brunnerse/Realtime-AES-accelerator/Diagrams/PipelinedAEA.pdf

PipelinedAEA

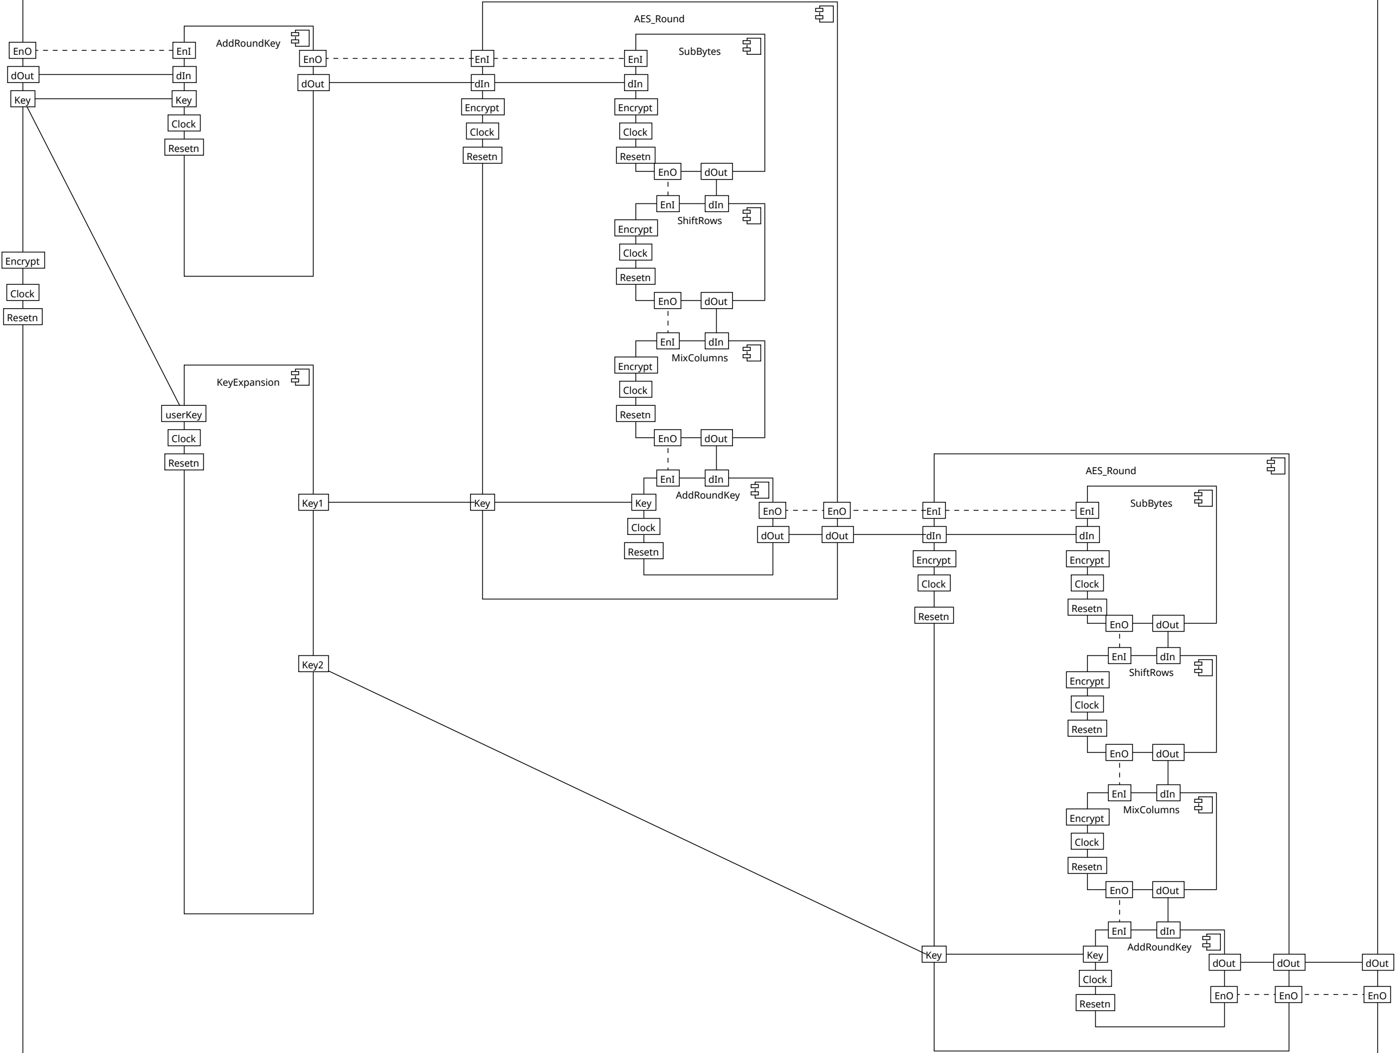
[picture p1: figure]
SubBytes; ShiftRows; AES_Round; MixColumns; AddRoundKey; KeyExpansion; EnI; Key; Clock; Resetn; EnO; dOut; dIn; userKey; Key1; Key2; Encrypt
