brunnerse/Realtime-AES-accelerator/Diagrams/ControlLogic Ports.png

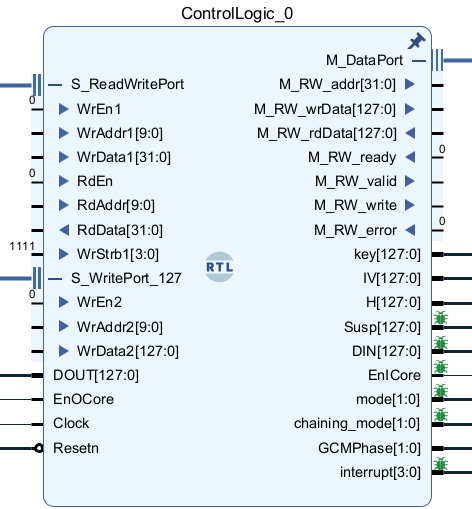
Diagrams/ControlLogic Ports.png
