brunnerse/Realtime-AES-accelerator/Diagrams/simple_ChannelChange_Sim.png

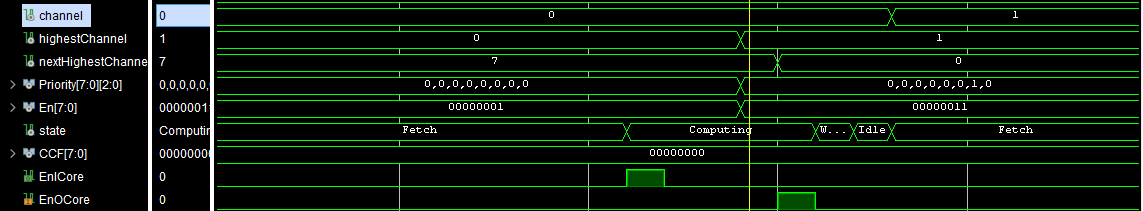
Diagrams/simple_ChannelChange_Sim.png
