brunnerse/Realtime-AES-accelerator/Diagrams/Waveform_GCM_Header_Processing.png

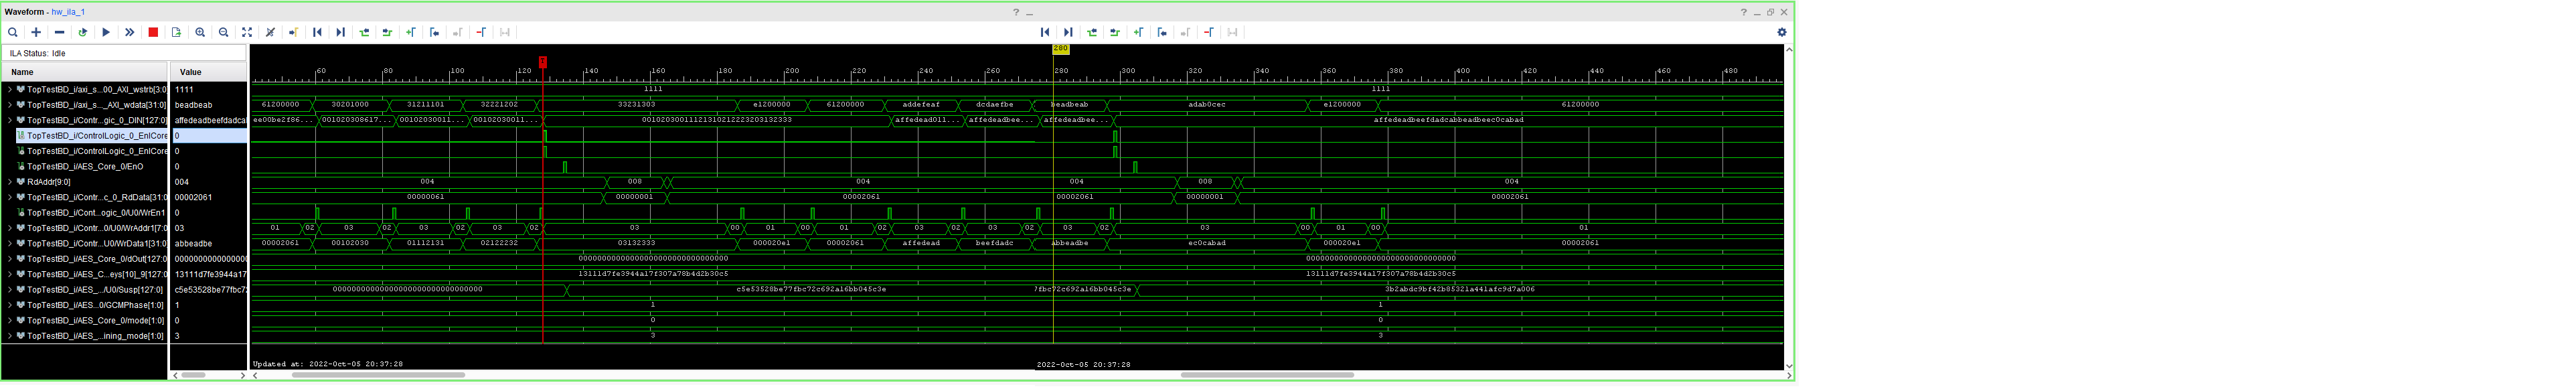
Diagrams/Waveform_GCM_Header_Processing.png
