brunnerse/Realtime-AES-accelerator/Test/aes_test_output.txt

Running AES_Unit_2 test file ../src/aes_test.c
Enabling exceptions..
******************************
* User Peripheral Self Test
******************************

User logic memory test...
   - local memory address is 0x40000000
   - write pattern to local BRAM and read back
   - write/read memory passed

====== Testing Interrupt enable/disable =====
Starting Encryption with Interrupt enabled...
[INTERRUPT] Received Irq 1
[Interrupt] Calling CbFunction at 11C084
=> Interrupt called for channel 0!
Starting KeyExpansion with Interrupt disabled...
Starting KeyExpansion with Interrupt enabled...
[INTERRUPT] Received Irq 1
[Interrupt] Calling CbFunction at 11C084
=> Interrupt called for channel 1337!

====== Testing simple ECB encryption for each channel =====
Plaintext:
        00 10 20 30 01 11 21 31 02 12 22 32 03 13 23 33 

Channel 0:
[INTERRUPT] Received Irq 1
[Interrupt] Calling CbFunction at 11C084
=> Interrupt called for channel 0!
        37 C2 53 91 28 69 90 09 61 7D 4D 89 35 E6 6C 12 

        Encrypt with different key:
        [INTERRUPT] Received Irq 1
        37 C2 53 91 28 69 90 09 61 7D 4D 89 35 E6 6C 12 

        Decrypt with same key:
[INTERRUPT] Received Irq 1
[Interrupt] Calling CbFunction at 11C084
=> Interrupt called for channel 0!
        00 10 20 30 01 11 21 31 02 12 22 32 03 13 23 33 

[TEST] Channel 0 successful:  Yes
Channel 1:
[INTERRUPT] Received Irq 2
[Interrupt] Calling CbFunction at 11C088
=> Interrupt called for channel 1!
        7F CE C6 AA CF C7 E0 9B AD E3 AA 3E B9 A2 42 40 

        Encrypt with different key:
        [INTERRUPT] Received Irq 2
        37 C2 53 91 28 69 90 09 61 7D 4D 89 35 E6 6C 12 

        Decrypt with same key:
[INTERRUPT] Received Irq 2
[Interrupt] Calling CbFunction at 11C088
=> Interrupt called for channel 1!
        00 10 20 30 01 11 21 31 02 12 22 32 03 13 23 33 

[TEST] Channel 1 successful:  Yes
Channel 2:
[INTERRUPT] Received Irq 4
[Interrupt] Calling CbFunction at 11C08C
=> Interrupt called for channel 2!
        94 A5 46 5F FE AE AF 81 DE A1 1C 34 F4 08 63 A1 

        Encrypt with different key:
        [INTERRUPT] Received Irq 4
        37 C2 53 91 28 69 90 09 61 7D 4D 89 35 E6 6C 12 

        Decrypt with same key:
[INTERRUPT] Received Irq 4
[Interrupt] Calling CbFunction at 11C08C
=> Interrupt called for channel 2!
        00 10 20 30 01 11 21 31 02 12 22 32 03 13 23 33 

[TEST] Channel 2 successful:  Yes
Channel 3:
[INTERRUPT] Received Irq 8
[Interrupt] Calling CbFunction at 11C090
=> Interrupt called for channel 3!
        85 51 01 76 4E F4 7C E9 09 62 D0 1B 0F B6 42 4C 

        Encrypt with different key:
        [INTERRUPT] Received Irq 8
        37 C2 53 91 28 69 90 09 61 7D 4D 89 35 E6 6C 12 

        Decrypt with same key:
[INTERRUPT] Received Irq 8
[Interrupt] Calling CbFunction at 11C090
=> Interrupt called for channel 3!
        00 10 20 30 01 11 21 31 02 12 22 32 03 13 23 33 

[TEST] Channel 3 successful:  Yes
Channel 4:
[INTERRUPT] Received Irq 10
[Interrupt] Calling CbFunction at 11C094
=> Interrupt called for channel 4!
        D8 43 A0 CD B1 4C 40 0A 67 91 DC F6 50 42 0A F1 

        Encrypt with different key:
        [INTERRUPT] Received Irq 10
        37 C2 53 91 28 69 90 09 61 7D 4D 89 35 E6 6C 12 

        Decrypt with same key:
[INTERRUPT] Received Irq 10
[Interrupt] Calling CbFunction at 11C094
=> Interrupt called for channel 4!
        00 10 20 30 01 11 21 31 02 12 22 32 03 13 23 33 

[TEST] Channel 4 successful:  Yes
Channel 5:
[INTERRUPT] Received Irq 20
[Interrupt] Calling CbFunction at 11C098
=> Interrupt called for channel 5!
        8E 92 87 E4 6E 09 D7 13 61 60 DE 90 4D 09 BA 57 

        Encrypt with different key:
        [INTERRUPT] Received Irq 20
        37 C2 53 91 28 69 90 09 61 7D 4D 89 35 E6 6C 12 

        Decrypt with same key:
[INTERRUPT] Received Irq 20
[Interrupt] Calling CbFunction at 11C098
=> Interrupt called for channel 5!
        00 10 20 30 01 11 21 31 02 12 22 32 03 13 23 33 

[TEST] Channel 5 successful:  Yes
Channel 6:
[INTERRUPT] Received Irq 40
[Interrupt] Calling CbFunction at 11C09C
=> Interrupt called for channel 6!
        BE 49 74 2A 9D 77 DF D6 B8 33 33 2F F9 68 56 03 

        Encrypt with different key:
        [INTERRUPT] Received Irq 40
        37 C2 53 91 28 69 90 09 61 7D 4D 89 35 E6 6C 12 

        Decrypt with same key:
[INTERRUPT] Received Irq 40
[Interrupt] Calling CbFunction at 11C09C
=> Interrupt called for channel 6!
        00 10 20 30 01 11 21 31 02 12 22 32 03 13 23 33 

[TEST] Channel 6 successful:  Yes
Channel 7:
[INTERRUPT] Received Irq 80
[Interrupt] Calling CbFunction at 11C0A0
=> Interrupt called for channel 7!
        20 FE 98 3B 01 36 CB 64 B1 9F 61 CD 57 D9 80 86 

        Encrypt with different key:
        [INTERRUPT] Received Irq 80
        37 C2 53 91 28 69 90 09 61 7D 4D 89 35 E6 6C 12 

        Decrypt with same key:
[INTERRUPT] Received Irq 80
[Interrupt] Calling CbFunction at 11C0A0
=> Interrupt called for channel 7!
        00 10 20 30 01 11 21 31 02 12 22 32 03 13 23 33 

[TEST] Channel 7 successful:  Yes

====== Testing different data sizes =====
Starting encryption...
[INTERRUPT] Received Irq 8
        00 10 20 30 01 11 21 31 02 12 22 32 03 13 23 33 
        01 10 20 30 01 11 21 31 02 12 22 32 03 13 23 33 

        AE DF 39 43 11 2F 08 82 78 12 C7 68 77 92 FF 64 
        2F A5 E5 A2 40 EF 34 00 DE 5A DB F3 DD FD AD 36 

Starting decryption...
[INTERRUPT] Received Irq 8
        00 10 20 30 01 11 21 31 02 12 22 32 03 13 23 33 
        01 10 20 30 01 11 21 31 02 12 22 32 03 13 23 33 

[TEST] Size 128 (addresses 0x1000000 -> 0x1000080) successful:  Yes
Starting encryption...
[INTERRUPT] Received Irq 8
        08 10 20 30 01 11 21 31 02 12 22 32 03 13 23 33 
        09 10 20 30 01 11 21 31 02 12 22 32 03 13 23 33 

        F1 A1 E4 08 A1 85 8A 8F 97 3D 11 7C 71 49 2F 9B 
        C7 8F 20 8B 3C 64 F6 A3 B2 BA EC CB 87 14 20 39 

Starting decryption...
[INTERRUPT] Received Irq 8
        08 10 20 30 01 11 21 31 02 12 22 32 03 13 23 33 
        09 10 20 30 01 11 21 31 02 12 22 32 03 13 23 33 

[TEST] Size 256 (addresses 0x1000000 -> 0x1000100) successful:  Yes
Starting encryption...
[INTERRUPT] Received Irq 8
        18 10 20 30 01 11 21 31 02 12 22 32 03 13 23 33 
        19 10 20 30 01 11 21 31 02 12 22 32 03 13 23 33 

        FF E0 86 BB DA F6 8A 13 77 79 EF 12 FB 8C 80 1C 
        82 1F CF 64 69 AB 59 F7 12 FF 57 F4 7C 77 0C 21 

Starting decryption...
[INTERRUPT] Received Irq 8
        18 10 20 30 01 11 21 31 02 12 22 32 03 13 23 33 
        19 10 20 30 01 11 21 31 02 12 22 32 03 13 23 33 

[TEST] Size 512 (addresses 0x1000000 -> 0x1000200) successful:  Yes
Starting encryption...
[INTERRUPT] Received Irq 8
        38 10 20 30 01 11 21 31 02 12 22 32 03 13 23 33 
        39 10 20 30 01 11 21 31 02 12 22 32 03 13 23 33 

        AF 28 16 45 35 66 BE 9B 49 84 63 73 F8 95 38 5B 
        BE 1E 1E C0 24 BD 6D 24 E9 98 2C CE 98 6F F2 BB 

Starting decryption...
[INTERRUPT] Received Irq 8
        38 10 20 30 01 11 21 31 02 12 22 32 03 13 23 33 
        39 10 20 30 01 11 21 31 02 12 22 32 03 13 23 33 

[TEST] Size 1024 (addresses 0x1000000 -> 0x1000400) successful:  Yes
Starting encryption...
[INTERRUPT] Received Irq 8
        78 10 20 30 01 11 21 31 02 12 22 32 03 13 23 33 
        79 10 20 30 01 11 21 31 02 12 22 32 03 13 23 33 

        6E D2 C9 38 0C A5 67 EB EF B5 B0 45 A1 CD EF A0 
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
[INTERRUPT] Received Irq 2
Ciphertext:
        F1 20 80 EA 46 8D C9 F0 B6 01 91 8A 30 69 3D ED 
        EB 7E 93 77 21 D5 26 1A 72 4F 50 40 99 64 70 14 
        4D 54 F4 B8 08 54 30 A7 C1 6F 17 74 60 67 E9 10 

Tag after encryption:
        A7 45 9D AE C1 C2 AC A4 26 7C 50 D3 68 57 45 62 

[INTERRUPT] Received Irq 2
[INTERRUPT] Received Irq 2
[INTERRUPT] Received Irq 2
[INTERRUPT] Received Irq 2
Deciphered Ciphertext:
        01 10 20 30 01 11 21 31 02 12 22 32 03 13 23 33 
        00 10 20 30 01 11 21 31 02 12 22 32 03 13 23 33 
        00 01 02 03 04 05 06 07 08 09 0A 0B 0C 0D 0E 0F 

Tag after decryption:
        A7 45 9D AE C1 C2 AC A4 26 7C 50 D3 68 57 45 62 

[TEST] Passed: Tags are equal
Processed all AES tests.
