brunnerse/Realtime-AES-accelerator/Vivado/AES_Unit_Stage2_comparison_CDMA.pdf

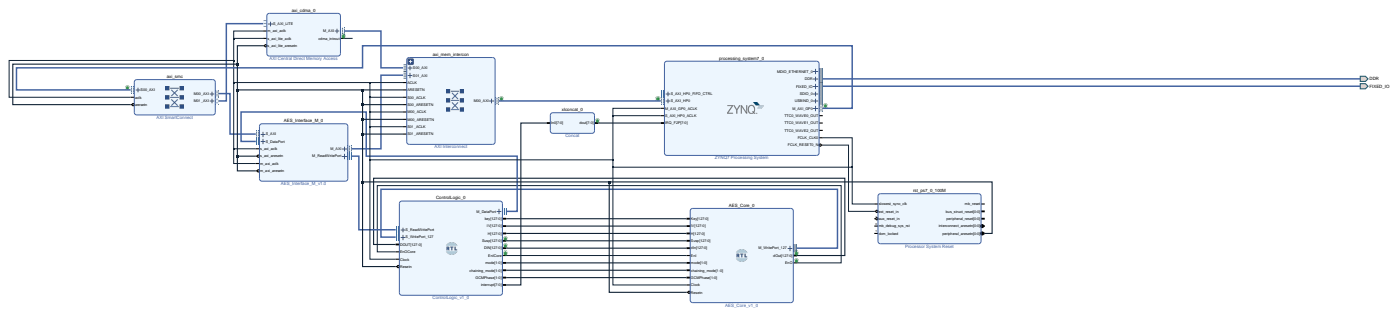
[picture p5: page 1]
AES_Core_0; AES_Core_v1_0; M_WritePort_127; Key[127:0]; IV[127:0] H[127:0] Susp[127:0] dIn[127:0] EnI; dOut[127:0] mode[1:0]; EnO; AES_Interface_M_0; AES_Interface_M_v1.0; S_AXI; M_AXI M_ReadWritePort; S_DataPort s_axi_aclk; s_axi_aresetn m_axi_aclk m_axi_aresetn; ControlLogic_0; ControlLogic_v1_0; S_ReadWritePort; M_DataPort; S_WritePort_127; key[127:0]; IV[127:0] H[127:0] Susp[127:0] DIN[127:0] DOUT[127:0]; EnICore EnOCore; mode[1:0] chaining_mode[1:0] GCMPhase[1:0]; interrupt[7:0]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

AXI Central Direct Memory Access

Processor System Reset

chaining_mode[1:0] GCMPhase[1:0] Clock Resetn
