brunnerse/Realtime-AES-accelerator/Diagrams/AES_Unit.pdf

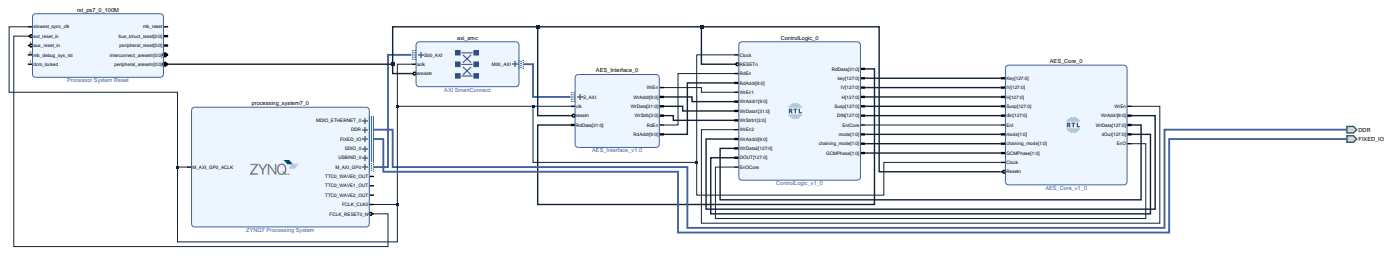
[picture p6: page 1]
rst_ps7_0_100M; slowest_sync_clk ext_reset_in; aux_reset_in ¹; mb_debug_sys_rst ⁰; dcm_locked ¹; mb_reset bus_struct_reset[0:0] peripheral_reset[0:0]; interconnect_aresetn[0:0] peripheral_aresetn[0:0]; processing_system7_0; ZYNQ7 Processing System; MDIO_ETHERNET_0 DDR; FIXED_IO; SDIO_0 USBIND_0 M_AXI_GP0 TTC0_WAVE0_OUT; TTC0_WAVE1_OUT; TTC0_WAVE2_OUT; M_AXI_GP0_ACLK; FCLK_CLK0 FCLK_RESET0_N; axi_smc; AXI SmartConnect; S00_AXI aclk; M00_AXI aresetn; AES_Interface_0; AES_Interface_v1.0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

Clock RESETn RdEn RdAddr[9:0]

Processor System Reset

RdData[31:0]
key[127:0]
IV[127:0] H[127:0] Susp[127:0] DIN[127:0]

WrEn WrAddr[9:0] WrData[31:0] WrStrb[3:0] RdEn RdAddr[9:0]

dIn[127:0]
EnI
EnO mode[1:0] chaining_mode[1:0] GCMPhase[1:0] Clock Resetn
