brunnerse/Realtime-AES-accelerator/AES/AES.srcs/sources_1/new/ControlLogic.vhd

----------------------------------------------------------------------------------
-- Company: 
-- Engineer: 
-- 
-- Create Date: 28.07.2022 21:02:50
-- Design Name: 
-- Module Name: ControlLogic - Behavioral
-- Project Name: 
-- Target Devices: 
-- Tool Versions: 
-- Description: 
-- 
-- Dependencies: 
-- 
-- Revision:
-- Revision 0.01 - File Created
-- Additional Comments:
-- 
----------------------------------------------------------------------------------


library IEEE;
use IEEE.STD_LOGIC_1164.ALL;
use work.common.ALL;

-- Uncomment the following library declaration if using
-- arithmetic functions with Signed or Unsigned values
--use IEEE.NUMERIC_STD.ALL;

-- Uncomment the following library declaration if instantiating
-- any Xilinx leaf cells in this code.
--library UNISIM;
--use UNISIM.VComponents.all;




entity ControlLogic is
  Port ( 
-- global signals
    RESETn   : in std_logic;
-- Ports to the AHB interface
    AES_KEYRx   : in std_logic_vector (KEY_SIZE-1 downto 0);
    AES_IVRx    : in std_logic_vector (KEY_SIZE-1 downto 0);
    AES_SR  : out std_logic_vector (31 downto 0);
    AES_CR : in std_logic_vector (31 downto 0);
    AES_DINR : in std_logic_vector (31 downto 0);
    AES_DOUTR : out std_logic_vector (31 downto 0);
-- Ports to the AES Core
    key : out std_logic_vector (KEY_SIZE-1 downto 0);
    IV : out std_logic_vector (KEY_SIZE-1 downto 0);
    DIN : out std_logic_vector (KEY_SIZE-1 downto 0); -- TODO 32 oder 128 bit?
    DOUT : in std_logic_vector (KEY_SIZE-1 downto 0);
-- Control to AES core
    en : out std_logic;
    mode : out std_logic_vector (1 downto 0);
    chaining_mode : out std_logic_vector (2 downto 0)
  );
end ControlLogic;

architecture Behavioral of ControlLogic is


-- TODO Was mit SUSPRx anfangen?
signal AES_SUSPRx  : std_logic_vector (31 downto 0);

begin

status <= AES_SR;
AES_CR <= control;

DIN <= AES_DINR;
AES_DOUTR <= DOUT;

key <= AES_KEYRx;
IV <= AES_IVRx;

-- set AES control signals
en <= AES_CR(0);
mode <= AES_CR(4 downto 3);
chaining_mode <= AES_CR(16) & AES_CR(6 downto 5);


-- TODO Process to clear AES_SR
process (RESETn)
begin
if RESETn = '0' then
    AES_SR <= x"00000000";
end if;
end process;


end Behavioral;
