brunnerse/Realtime-AES-accelerator/VHDL/AES_Unit.vhd

library IEEE;
use IEEE.STD_LOGIC_1164.ALL;
use work.common.ALL;
use work.addresses.ALL;

-- Uncomment the following library declaration if using
-- arithmetic functions with Signed or Unsigned values
use IEEE.NUMERIC_STD.ALL;


entity AES_Unit is
  Generic (
    LITTLE_ENDIAN : boolean := true; -- whether the AXI bus data signals use little endian byte order
    REG_KEY_WRITEONLY : boolean := true; -- whether the registers Key, IV, Susp and H are not allowed to be read for security 
    NO_REG_WRITE_WHEN_ENABLED : boolean := true; -- whether writing to a channel is only possible when the channel is not enabled 
    NUM_CHANNELS : integer range 1 to 256 := 8; -- the number of channels; the upper bound is equal to MAX_CHANNELS defined in common.vhd 
    -- Parameters of the AXI Slave Bus Interface S_AXI
    C_S_AXI_ID_WIDTH	: integer	:= 1;
    C_S_AXI_DATA_WIDTH	: integer	:= 32;
    C_S_AXI_ADDR_WIDTH	: integer	:= ADDR_WIDTH;
    C_S_AXI_AWUSER_WIDTH	: integer	:= 1;
    C_S_AXI_ARUSER_WIDTH	: integer	:= 1;
    C_S_AXI_WUSER_WIDTH	: integer	:= 1;
    C_S_AXI_RUSER_WIDTH	: integer	:= 1;
    C_S_AXI_BUSER_WIDTH	: integer	:= 1;
    -- Parameters of AXI Master Bus Interface M_AXI
    C_M_AXI_ID_WIDTH	: integer	:= 1;
    C_M_AXI_ADDR_WIDTH	: integer	:= 32;
    C_M_AXI_DATA_WIDTH	: integer	:= 32;
    C_M_AXI_AWUSER_WIDTH	: integer	:= 1;
    C_M_AXI_ARUSER_WIDTH	: integer	:= 1;
    C_M_AXI_WUSER_WIDTH	: integer	:= 1;
    C_M_AXI_RUSER_WIDTH	: integer	:= 1;
    C_M_AXI_BUSER_WIDTH	: integer	:= 1
  );
  Port ( 
	-- Ports of Axi Slave Bus Interface S_AXI
		s_axi_aclk	: in std_logic;
		s_axi_aresetn	: in std_logic;
		s_axi_awid	: in std_logic_vector(C_S_AXI_ID_WIDTH-1 downto 0);
		s_axi_awaddr	: in std_logic_vector(C_S_AXI_ADDR_WIDTH-1 downto 0);
		s_axi_awlen	: in std_logic_vector(7 downto 0);
		s_axi_awsize	: in std_logic_vector(2 downto 0);
		s_axi_awburst	: in std_logic_vector(1 downto 0);
		s_axi_awlock	: in std_logic;
		s_axi_awcache	: in std_logic_vector(3 downto 0);
		s_axi_awprot	: in std_logic_vector(2 downto 0);
		s_axi_awqos	: in std_logic_vector(3 downto 0);
		s_axi_awregion	: in std_logic_vector(3 downto 0);
		s_axi_awuser	: in std_logic_vector(C_S_AXI_AWUSER_WIDTH-1 downto 0);
		s_axi_awvalid	: in std_logic;
		s_axi_awready	: out std_logic;
		s_axi_wdata	: in std_logic_vector(C_S_AXI_DATA_WIDTH-1 downto 0);
		s_axi_wstrb	: in std_logic_vector((C_S_AXI_DATA_WIDTH/8)-1 downto 0);
		s_axi_wlast	: in std_logic;
		s_axi_wuser	: in std_logic_vector(C_S_AXI_WUSER_WIDTH-1 downto 0);
		s_axi_wvalid	: in std_logic;
		s_axi_wready	: out std_logic;
		s_axi_bid	: out std_logic_vector(C_S_AXI_ID_WIDTH-1 downto 0);
		s_axi_bresp	: out std_logic_vector(1 downto 0);
		s_axi_buser	: out std_logic_vector(C_S_AXI_BUSER_WIDTH-1 downto 0);
		s_axi_bvalid	: out std_logic;
		s_axi_bready	: in std_logic;
		s_axi_arid	: in std_logic_vector(C_S_AXI_ID_WIDTH-1 downto 0);
		s_axi_araddr	: in std_logic_vector(C_S_AXI_ADDR_WIDTH-1 downto 0);
		s_axi_arlen	: in std_logic_vector(7 downto 0);
		s_axi_arsize	: in std_logic_vector(2 downto 0);
		s_axi_arburst	: in std_logic_vector(1 downto 0);
		s_axi_arlock	: in std_logic;
		s_axi_arcache	: in std_logic_vector(3 downto 0);
		s_axi_arprot	: in std_logic_vector(2 downto 0);
		s_axi_arqos	: in std_logic_vector(3 downto 0);
		s_axi_arregion	: in std_logic_vector(3 downto 0);
		s_axi_aruser	: in std_logic_vector(C_S_AXI_ARUSER_WIDTH-1 downto 0);
		s_axi_arvalid	: in std_logic;
		s_axi_arready	: out std_logic;
		s_axi_rid	: out std_logic_vector(C_S_AXI_ID_WIDTH-1 downto 0);
		s_axi_rdata	: out std_logic_vector(C_S_AXI_DATA_WIDTH-1 downto 0);
		s_axi_rresp	: out std_logic_vector(1 downto 0);
		s_axi_rlast	: out std_logic;
		s_axi_ruser	: out std_logic_vector(C_S_AXI_RUSER_WIDTH-1 downto 0);
		s_axi_rvalid	: out std_logic;
		s_axi_rready	: in std_logic;

		-- Ports of Axi Master Bus Interface M_AXI
		m_axi_aclk	: in std_logic;
		m_axi_aresetn	: in std_logic;
		m_axi_awid	: out std_logic_vector(C_M_AXI_ID_WIDTH-1 downto 0);
		m_axi_awaddr	: out std_logic_vector(C_M_AXI_ADDR_WIDTH-1 downto 0);
		m_axi_awlen	: out std_logic_vector(7 downto 0);
		m_axi_awsize	: out std_logic_vector(2 downto 0);
		m_axi_awburst	: out std_logic_vector(1 downto 0);
		m_axi_awlock	: out std_logic;
		m_axi_awcache	: out std_logic_vector(3 downto 0);
		m_axi_awprot	: out std_logic_vector(2 downto 0);
		m_axi_awqos	: out std_logic_vector(3 downto 0);
		m_axi_awuser	: out std_logic_vector(C_M_AXI_AWUSER_WIDTH-1 downto 0);
		m_axi_awvalid	: out std_logic;
		m_axi_awready	: in std_logic;
		m_axi_wdata	: out std_logic_vector(C_M_AXI_DATA_WIDTH-1 downto 0);
		m_axi_wstrb	: out std_logic_vector(C_M_AXI_DATA_WIDTH/8-1 downto 0);
		m_axi_wlast	: out std_logic;
		m_axi_wuser	: out std_logic_vector(C_M_AXI_WUSER_WIDTH-1 downto 0);
		m_axi_wvalid	: out std_logic;
		m_axi_wready	: in std_logic;
		m_axi_bid	: in std_logic_vector(C_M_AXI_ID_WIDTH-1 downto 0);
		m_axi_bresp	: in std_logic_vector(1 downto 0);
		m_axi_buser	: in std_logic_vector(C_M_AXI_BUSER_WIDTH-1 downto 0);
		m_axi_bvalid	: in std_logic;
		m_axi_bready	: out std_logic;
		m_axi_arid	: out std_logic_vector(C_M_AXI_ID_WIDTH-1 downto 0);
		m_axi_araddr	: out std_logic_vector(C_M_AXI_ADDR_WIDTH-1 downto 0);
		m_axi_arlen	: out std_logic_vector(7 downto 0);
		m_axi_arsize	: out std_logic_vector(2 downto 0);
		m_axi_arburst	: out std_logic_vector(1 downto 0);
		m_axi_arlock	: out std_logic;
		m_axi_arcache	: out std_logic_vector(3 downto 0);
		m_axi_arprot	: out std_logic_vector(2 downto 0);
		m_axi_arqos	: out std_logic_vector(3 downto 0);
		m_axi_aruser	: out std_logic_vector(C_M_AXI_ARUSER_WIDTH-1 downto 0);
		m_axi_arvalid	: out std_logic;
		m_axi_arready	: in std_logic;
		m_axi_rid	: in std_logic_vector(C_M_AXI_ID_WIDTH-1 downto 0);
		m_axi_rdata	: in std_logic_vector(C_M_AXI_DATA_WIDTH-1 downto 0);
		m_axi_rresp	: in std_logic_vector(1 downto 0);
		m_axi_rlast	: in std_logic;
		m_axi_ruser	: in std_logic_vector(C_M_AXI_RUSER_WIDTH-1 downto 0);
		m_axi_rvalid	: in std_logic;
		m_axi_rready	: out std_logic;
		-- Interrupt out
		aes_introut : out std_logic
  );
end entity;

architecture Structural of AES_Unit is

-- Define ahb ports as xiling AHB_INTERFACE
ATTRIBUTE X_INTERFACE_INFO : STRING;
ATTRIBUTE X_INTERFACE_PARAMETER : STRING;


-- signals to master AES Interface
signal    M_RV_valid :  std_logic;
signal    M_RV_ready : std_logic;
signal    M_RV_addr : std_logic_vector(31 downto 0);
signal    M_RV_wrData : block_t;
signal    M_RV_rdData : block_t;
signal    M_RV_write : std_logic; 
signal    M_RV_error : std_logic;

signal IWrAddr, IRdAddr : std_logic_vector(C_S_AXI_ADDR_WIDTH-1 downto 0);
signal WrAddrCore : std_logic_vector(ADDR_REGISTER_BITS-1 downto 0);
signal IWrData, IRdData : std_logic_vector(31 downto 0);
signal WrDataCore : block_t;
signal IWrEn, IRdEn, WrEnCore : std_logic;
signal IWrStrb : std_logic_vector(3 downto 0);

-- signals between ControlLogic and Core
signal key : key_t;
signal IV, DIN, DOUT, H, Susp : block_t;
signal EnICore, EnOCore : std_logic;

signal mode, GCMPhase, chaining_mode : mode_t;


begin


i_AES_Interface : entity work.AES_Interface
    generic map (
		LITTLE_ENDIAN 		=> LITTLE_ENDIAN,
        C_S_AXI_ID_WIDTH	=> C_S_AXI_ID_WIDTH,	
        C_S_AXI_DATA_WIDTH	=> C_S_AXI_DATA_WIDTH,	
        C_S_AXI_ADDR_WIDTH	=> C_S_AXI_ADDR_WIDTH,	
        C_S_AXI_AWUSER_WIDTH => C_S_AXI_AWUSER_WIDTH,	
        C_S_AXI_ARUSER_WIDTH => C_S_AXI_ARUSER_WIDTH,	
        C_S_AXI_WUSER_WIDTH	=> C_S_AXI_WUSER_WIDTH,	
        C_S_AXI_RUSER_WIDTH	=> C_S_AXI_RUSER_WIDTH,	
        C_S_AXI_BUSER_WIDTH	=> C_S_AXI_BUSER_WIDTH,	
        
        C_M_AXI_ID_WIDTH	=> C_M_AXI_ID_WIDTH,	
        C_M_AXI_ADDR_WIDTH	=> C_M_AXI_ADDR_WIDTH,	
        C_M_AXI_DATA_WIDTH	=> C_M_AXI_DATA_WIDTH,	
        C_M_AXI_AWUSER_WIDTH => C_M_AXI_AWUSER_WIDTH,	
        C_M_AXI_ARUSER_WIDTH => C_M_AXI_ARUSER_WIDTH,	
        C_M_AXI_WUSER_WIDTH	=> C_M_AXI_WUSER_WIDTH,	
        C_M_AXI_RUSER_WIDTH	=> C_M_AXI_RUSER_WIDTH,	
        C_M_AXI_BUSER_WIDTH	=> C_M_AXI_BUSER_WIDTH	)
    port map (
        RdEn => IRdEn,
        RdAddr => IRdAddr,
        RdData => IRdData, 
        WrEn => IWrEn,
        WrAddr => IWrAddr, 
        WrData => IWrData,
        WrStrb => IWrStrb,
        S_RV_valid => M_RV_valid,
        S_RV_ready => M_RV_ready,
        S_RV_addr => M_RV_addr,
        S_RV_wrData => M_RV_wrData,
        S_RV_rdData => M_RV_rdData,
        S_RV_write => M_RV_write,
        S_RV_error => M_RV_error,
        -- Slave AXI port
        s_axi_aclk => s_axi_aclk,
		s_axi_aresetn => s_axi_aresetn,
		s_axi_awid => s_axi_awid,
		s_axi_awaddr => s_axi_awaddr,
		s_axi_awlen => s_axi_awlen,
		s_axi_awsize => s_axi_awsize,
		s_axi_awburst => s_axi_awburst,
		s_axi_awlock => s_axi_awlock,
		s_axi_awcache => s_axi_awcache,
		s_axi_awprot => s_axi_awprot,
		s_axi_awqos => s_axi_awqos,
		s_axi_awregion => s_axi_awregion,
		s_axi_awuser => s_axi_awuser,
		s_axi_awvalid => s_axi_awvalid,
		s_axi_awready => s_axi_awready,
		s_axi_wdata => s_axi_wdata,
		s_axi_wstrb => s_axi_wstrb,
		s_axi_wlast => s_axi_wlast,
		s_axi_wuser => s_axi_wuser,
		s_axi_wvalid => s_axi_wvalid,
		s_axi_wready => s_axi_wready,
		s_axi_bid => s_axi_bid,
		s_axi_bresp => s_axi_bresp,
		s_axi_buser => s_axi_buser,
		s_axi_bvalid => s_axi_bvalid,
		s_axi_bready => s_axi_bready,
		s_axi_arid => s_axi_arid,
		s_axi_araddr => s_axi_araddr,
		s_axi_arlen => s_axi_arlen,
		s_axi_arsize => s_axi_arsize,
		s_axi_arburst => s_axi_arburst,
		s_axi_arlock => s_axi_arlock,
		s_axi_arcache => s_axi_arcache,
		s_axi_arprot => s_axi_arprot,
		s_axi_arqos => s_axi_arqos,
		s_axi_arregion => s_axi_arregion,
		s_axi_aruser => s_axi_aruser,
		s_axi_arvalid => s_axi_arvalid,
		s_axi_arready => s_axi_arready,
		s_axi_rid => s_axi_rid,
		s_axi_rdata => s_axi_rdata,
		s_axi_rresp => s_axi_rresp,
		s_axi_rlast => s_axi_rlast,
		s_axi_ruser => s_axi_ruser,
		s_axi_rvalid => s_axi_rvalid,
		s_axi_rready => s_axi_rready,
		-- Ports of Axi Master Bus Interface M_AXI
		m_axi_aclk => m_axi_aclk,
		m_axi_aresetn => m_axi_aresetn,
		m_axi_awid => m_axi_awid,
		m_axi_awaddr => m_axi_awaddr,
		m_axi_awlen => m_axi_awlen,
		m_axi_awsize => m_axi_awsize,
		m_axi_awburst => m_axi_awburst,
		m_axi_awlock => m_axi_awlock,
		m_axi_awcache => m_axi_awcache,
		m_axi_awprot => m_axi_awprot,
		m_axi_awqos => m_axi_awqos,
		m_axi_awuser => m_axi_awuser,
		m_axi_awvalid => m_axi_awvalid,
		m_axi_awready => m_axi_awready,
		m_axi_wdata => m_axi_wdata,
		m_axi_wstrb => m_axi_wstrb,
		m_axi_wlast => m_axi_wlast,
		m_axi_wuser => m_axi_wuser,
		m_axi_wvalid => m_axi_wvalid,
		m_axi_wready => m_axi_wready,
		m_axi_bid => m_axi_bid,
		m_axi_bresp => m_axi_bresp,
		m_axi_buser => m_axi_buser,
		m_axi_bvalid => m_axi_bvalid,
		m_axi_bready => m_axi_bready,
		m_axi_arid => m_axi_arid,
		m_axi_araddr => m_axi_araddr,
		m_axi_arlen => m_axi_arlen,
		m_axi_arsize => m_axi_arsize,
		m_axi_arburst => m_axi_arburst,
		m_axi_arlock => m_axi_arlock,
		m_axi_arcache => m_axi_arcache,
		m_axi_arprot => m_axi_arprot,
		m_axi_arqos => m_axi_arqos,
		m_axi_aruser => m_axi_aruser,
		m_axi_arvalid => m_axi_arvalid,
		m_axi_arready => m_axi_arready,
		m_axi_rid => m_axi_rid,
		m_axi_rdata => m_axi_rdata,
		m_axi_rresp => m_axi_rresp,
		m_axi_rlast => m_axi_rlast,
		m_axi_ruser => m_axi_ruser,
		m_axi_rvalid => m_axi_rvalid,
		m_axi_rready => m_axi_rready
     );


    
i_ControlLogic : entity work.ControlLogic
    generic map(
        LITTLE_ENDIAN => LITTLE_ENDIAN,
    	REG_KEY_WRITEONLY => REG_KEY_WRITEONLY, 
    	NO_REG_WRITE_WHEN_ENABLED => NO_REG_WRITE_WHEN_ENABLED, 
        NUM_CHANNELS => NUM_CHANNELS)
    port map(
        M_RV_valid => M_RV_valid,
        M_RV_ready => M_RV_ready,
        M_RV_error => M_RV_error, 
        M_RV_rdData => M_RV_rdData,
        M_RV_wrData => M_RV_wrData,
        M_RV_addr => M_RV_addr,
        M_RV_write => M_RV_write,
        RdEn => IRdEn,
        RdAddr => IRdAddr,
        RdData => IRdData, 
        WrEn1 => IWrEn,
        WrAddr1 => IWrAddr,
        WrData1 => IWrData,
        WrStrb1 => IWrStrb,
        WrEn2 => WrEnCore,
        WrAddr2 => WrAddrCore,
        WrData2 => WrDataCore, 
        key => key,
        IV => IV,
        H => H,
        Susp => Susp,
        DIN => DIN,
        DOUT => DOUT,
        EnOCore => EnOCore,
        EnICore => EnICore,
        mode => mode,
        chaining_mode => chaining_mode,
        GCMPhase => GCMPhase,
        aes_introut => aes_introut,
        Clock => s_axi_aclk,
        Resetn => s_axi_aresetn
    );

i_Core : entity work.AES_Core
    generic map (
        ADDR_IV => ADDR_IVR,
        ADDR_SUSP => ADDR_SUSPR,
        ADDR_H => ADDR_HR)
    port map (
        key => key,
        IV => IV,
        H => H,
        Susp => Susp,
        WrEn => WrEnCore,
        WrAddr => WrAddrCore,
        WrData => WrDataCore,
        DIN => DIN,
        DOUT => DOUT,
        EnI => EnICore,
        EnO => EnOCore,
        mode => mode,
        chaining_mode => chaining_mode,
        GCMPhase => GCMPhase,
        Clock => s_axi_aclk,
        Resetn => s_axi_aresetn
    );

end architecture;
