brunnerse/Realtime-AES-accelerator/VHDL/AES_Core/AEA/Submodules/sbox.vhd

library IEEE;
use IEEE.STD_LOGIC_1164.ALL;
use IEEE.NUMERIC_STD.ALL;

package aes_sbox is


function SubBytesInVec(vec : std_logic_vector) return std_logic_vector;
function InvSubBytesInVec(vec : std_logic_vector) return std_logic_vector;

type SBOX is array(255 downto 0) of std_logic_vector(7 downto 0);

constant sbox_encrypt : SBOX := (
	  0 => x"63",
	  1 => x"7c",
	  2 => x"77",
	  3 => x"7b",
	  4 => x"f2",
	  5 => x"6b",
	  6 => x"6f",
	  7 => x"c5",
	  8 => x"30",
	  9 => x"01",
	 10 => x"67",
	 11 => x"2b",
	 12 => x"fe",
	 13 => x"d7",
	 14 => x"ab",
	 15 => x"76",
	 16 => x"ca",
	 17 => x"82",
	 18 => x"c9",
	 19 => x"7d",
	 20 => x"fa",
	 21 => x"59",
	 22 => x"47",
	 23 => x"f0",
	 24 => x"ad",
	 25 => x"d4",
	 26 => x"a2",
	 27 => x"af",
	 28 => x"9c",
	 29 => x"a4",
	 30 => x"72",
	 31 => x"c0",
	 32 => x"b7",
	 33 => x"fd",
	 34 => x"93",
	 35 => x"26",
	 36 => x"36",
	 37 => x"3f",
	 38 => x"f7",
	 39 => x"cc",
	 40 => x"34",
	 41 => x"a5",
	 42 => x"e5",
	 43 => x"f1",
	 44 => x"71",
	 45 => x"d8",
	 46 => x"31",
	 47 => x"15",
	 48 => x"04",
	 49 => x"c7",
	 50 => x"23",
	 51 => x"c3",
	 52 => x"18",
	 53 => x"96",
	 54 => x"05",
	 55 => x"9a",
	 56 => x"07",
	 57 => x"12",
	 58 => x"80",
	 59 => x"e2",
	 60 => x"eb",
	 61 => x"27",
	 62 => x"b2",
	 63 => x"75",
	 64 => x"09",
	 65 => x"83",
	 66 => x"2c",
	 67 => x"1a",
	 68 => x"1b",
	 69 => x"6e",
	 70 => x"5a",
	 71 => x"a0",
	 72 => x"52",
	 73 => x"3b",
	 74 => x"d6",
	 75 => x"b3",
	 76 => x"29",
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
	 98 => x"ab",
	 99 => x"00",
	100 => x"8c",
	101 => x"bc",
	102 => x"d3",
	103 => x"0a",
	104 => x"f7",
	105 => x"e4",
	106 => x"58",
	107 => x"05",
	108 => x"b8",
	109 => x"b3",
	110 => x"45",
	111 => x"06",
	112 => x"d0",
	113 => x"2c",
	114 => x"1e",
	115 => x"8f",
	116 => x"ca",
	117 => x"3f",
	118 => x"0f",
	119 => x"02",
	120 => x"c1",
	121 => x"af",
	122 => x"bd",
	123 => x"03",
	124 => x"01",
	125 => x"13",
	126 => x"8a",
	127 => x"6b",
	128 => x"3a",
	129 => x"91",
	130 => x"11",
	131 => x"41",
	132 => x"4f",
	133 => x"67",
	134 => x"dc",
	135 => x"ea",
	136 => x"97",
	137 => x"f2",
	138 => x"cf",
	139 => x"ce",
	140 => x"f0",
	141 => x"b4",
	142 => x"e6",
	143 => x"73",
	144 => x"96",
	145 => x"ac",
	146 => x"74",
	147 => x"22",
	148 => x"e7",
	149 => x"ad",
	150 => x"35",
	151 => x"85",
	152 => x"e2",
	153 => x"f9",
	154 => x"37",
	155 => x"e8",
	156 => x"1c",
	157 => x"75",
	158 => x"df",
	159 => x"6e",
	160 => x"47",
	161 => x"f1",
	162 => x"1a",
	163 => x"71",
	164 => x"1d",
	165 => x"29",
	166 => x"c5",
	167 => x"89",
	168 => x"6f",
	169 => x"b7",
	170 => x"62",
	171 => x"0e",
	172 => x"aa",
	173 => x"18",
	174 => x"be",
	175 => x"1b",
	176 => x"fc",
	177 => x"56",
	178 => x"3e",
	179 => x"4b",
	180 => x"c6",
	181 => x"d2",
	182 => x"79",
	183 => x"20",
	184 => x"9a",
	185 => x"db",
	186 => x"c0",
	187 => x"fe",
	188 => x"78",
	189 => x"cd",
	190 => x"5a",
	191 => x"f4",
	192 => x"1f",
	193 => x"dd",
	194 => x"a8",
	195 => x"33",
	196 => x"88",
	197 => x"07",
	198 => x"c7",
	199 => x"31",
	200 => x"b1",
	201 => x"12",
	202 => x"10",
	203 => x"59",
	204 => x"27",
	205 => x"80",
	206 => x"ec",
	207 => x"5f",
	208 => x"60",
	209 => x"51",
	210 => x"7f",
	211 => x"a9",
	212 => x"19",
	213 => x"b5",
	214 => x"4a",
	215 => x"0d",
	216 => x"2d",
	217 => x"e5",
	218 => x"7a",
	219 => x"9f",
	220 => x"93",
	221 => x"c9",
	222 => x"9c",
	223 => x"ef",
	224 => x"a0",
	225 => x"e0",
	226 => x"3b",
	227 => x"4d",
	228 => x"ae",
	229 => x"2a",
	230 => x"f5",
	231 => x"b0",
	232 => x"c8",
	233 => x"eb",
	234 => x"bb",
	235 => x"3c",
	236 => x"83",
	237 => x"53",
	238 => x"99",
	239 => x"61",
	240 => x"17",
	241 => x"2b",
	242 => x"04",
	243 => x"7e",
	244 => x"ba",
	245 => x"77",
	246 => x"d6",
	247 => x"26",
	248 => x"e1",
	249 => x"69",
	250 => x"14",
	251 => x"63",
	252 => x"55",
	253 => x"21",
	254 => x"0c",
	255 => x"7d"
);


end package;

package body aes_sbox is

	function SubBytesInVec(vec : std_logic_vector) return std_logic_vector is
		variable result : std_logic_vector(vec'range);
	begin
		for i in 0 to vec'length/8-1 loop
			result(i*8+7 downto i*8) := sbox_encrypt(to_integer(unsigned(vec(i*8+7 downto i*8))));
		end loop;
		return result;
	end function;

	function InvSubBytesInVec(vec : std_logic_vector) return std_logic_vector is
		variable result : std_logic_vector(vec'range);
	begin
		for i in 0 to vec'length/8-1 loop
			result(i*8+7 downto i*8) := sbox_decrypt(to_integer(unsigned(vec(i*8+7 downto i*8))));
		end loop;
		return result;
	end function;

end package body;
