brunnerse/Realtime-AES-accelerator/(commit log)

2022-08-04 Print single-digit hex numbers with two digits in BuildSBox.py
2022-08-09 Remove TABLE type and replace it with COLUMNTABLE
    At this point, encryption works correctly
    [AEA.vhd, AEA_Round.vhd, AddRoundKey.vhd, MixColumns.vhd, ShiftRows.vhd, SubBytes.vhd, TableToVector.vhd, TestComponents.vhd]
2022-08-09 Implement decryption in ShiftRows and MixColumns
    The implementations are tested and correct
    [MixColumns.vhd, ShiftRows.vhd]
2022-08-09 Fix typo in BuildSBox
    [BuildSBox.py, sbox_definition.vhd]
2022-08-09 Make decryption work
    Decryption has been tested, implementation at this point is correct
    [AEA.vhd, TestComponents.vhd]
2022-08-17 Rename reset port to resetn to indicate active low
    [AEA.vhd, AEA_Round.vhd, AES_Core.vhd, AddRoundKey.vhd, KeyExpansion.vhd, MixColumns.vhd, PipelinedAEA.vhd, ShiftRows.vhd]
2022-08-21 Extend AES python script with printing decryption aswell
2022-09-11 Shorten AEA.vhd by running KeyExpansion parallel
    [AEA.vhd, TestAEA.vhd]
2022-09-14 Replace PipelinedAEA with AEA in AES_Core.vhd
    [AES_Core.vhd, KeyExpansion.vhd]
2022-09-22 Start implementing driver for the AES_Interface IP
2022-09-22 Work on driver
2022-09-22 Update drivers of AES_Interface
2022-09-23 Implement more functions of the driver
2022-09-24 Fix inferred latch in ControlLogic
    [ControlLogic.vhd, TestControlLogic.vhd]
2022-09-26 Transform asynchronous resets to synchronous resets, remove latches
    [AEA.vhd, AES_Core.vhd, AES_Mode_ECBCBCCTR.vhd, AES_Mode_GCM.vhd, AXI_Mem_Interface.vhd, AddRoundKey.vhd, ControlLogic.vhd, KeyExpansion.vhd]
2022-09-28 Adapt TESTAEA.vhd to the synchronous reset (longer reset interval)
    [TestAEA.vhd]
2022-09-28 Change Length of chaining_mode from 3 to 2
2022-09-28 Change length of chaining_mode in drivers
2022-10-04 Fix non-constant indices in mulGF process of GCM mode
    [AES_Mode_GCM.vhd]
2022-10-04 Consider encryption or decryptoin in processDataGCM driver function
2022-10-05 Adapt some test files to synchronous reset
    [TestAESCore.vhd, TestAESCoreGCM.vhd]
2022-10-05 Fix small errors in processDataGCM() function of driver
2022-10-06 Add interrupt output signal to ControlLogic
2022-10-06 Create new test file for AES with interrupt
2022-10-06 Add Interrupt function to AES_Interface_M driver
2022-10-06 Add demonstrative code for working interrupt to aestest_interrupt.c
2022-10-12 Adapt Addresses in common.vhd to new DMA interface scheme
2022-10-12 Fix multiple drivers for EnICore signal in ControlLogic
    [ControlLogic.vhd]
2022-10-12 Fix false LittleEndian data forwarding in AES_Interface_M
    [AES_Interface_M_v1_0.vhd]
2022-10-12 Add shell script to quickly replace all driver files in the Vitis Project
2022-10-14 Adapt ControlLogic to DMA-style interface
    A process reads, computes and writes back the data
    The given address and datasize are converted from little endian to big
    endian
2022-10-14 Rewrite the drivers for the new AES DMA-style interface
2022-10-15 Fix write and read address in ControlLogic
    [ControlLogic.vhd, TestControlLogic.vhd]
2022-10-16 Adapt drivers to new channel system
2022-10-17 Add functions to get and set the priority of a channel to the drivers
2022-10-17 Extend interrupt signal to one interrupt per channel
2022-10-23 Fix minor mistakes in ControlLogic CCFC didn't work in some situations WritePort1 always wrote to the registers of the first channel
    [ControlLogic.vhd]
2022-10-23 Introduce dataCount array in ControlLogic
    The array stores how many bytes have been processed for this channel
    This way, the information is stored even when the channel is
    interrupted
2022-10-28 Fix return type of driver GetPriority() function
    Also consider the channel in AES_SetInterruptRoutine
2022-10-28 Reset CCF immediately once En is asserted for every channel
    [ControlLogic.vhd]
2022-10-28 Add C file for testing the CDMA AXI component
    Discovered that I need to flush the Data Cash when using a DMA
2022-10-28 Add Getters for Error Bits, IV and InterruptEnabled to driver
2022-10-29 Reset error bits in status register when channel is enabled
    [ControlLogic.vhd]
2022-11-02 Add new test c file aestest_channels.c for channels and DMA system
2022-11-03 Add DMA diagrams
2022-11-04 Change ControlLogic so it has only one interrupt signal for all channels
2022-11-04 Fix little endian conversion for 64-bit data width in AXI Master
    [AES_Interface_M_v1_0.vhd]
2022-11-04 Adapt driver as there is now only one interrupt signal for all channels
2022-11-05 Remove resolved TODOs, improve comments in several VHDL files
    [AEA.vhd, AES_Interface_M_v1_0.vhd, ControlLogic.vhd, PipelinedAEA.vhd, common.vhd]
2022-11-05 Improve minor things in the drivers
2022-11-05 Fix EnO signal of GCM Mode in Payload Encryption Phase
    [AES_Mode_GCM.vhd]
2022-11-05 Fix ControlLogic entity instantiation in AES_Unit.vhd
    [AES_Unit.vhd]
2022-11-05 Clear SUSP register in the driver instead of the hardware
    When ControlLogic cleared Susp, it was reset the 0 between the header
    and payload phase, which gives a wrong result
    To prevent this, the driver now clears Susp when starting a GCM
    computation
    [ControlLogic.vhd]
2022-11-05 Rename startNewComputationXXX driver functions to startComputationXXX
2022-11-17 Remove code of ControlLogic where a channel can be interrupted after fetch
2022-12-03 Change cdma_test to also test interrupts
2022-12-14 Extend AES.py script to print out the results for each channel setting
2022-12-14 Move error signals driving to separate process
    [ControlLogic.vhd]
2022-12-14 Fix bug in ControlLogic search process
    [ControlLogic.vhd, common.vhd]
2022-12-16 Implement several improvements in driver
    Add new function startComputationMode that takes a ChainingMode as
    argument
    Consider Endianness when calculating Tag in GCM Mode
2022-12-19 Reset Susp to 0 in Hardware instead of in the phase2 driver
    [AES_Mode_GCM.vhd]
2022-12-19 Fix EnO timing in GCM Init phase
    [AES_Mode_GCM.vhd]
2022-12-20 Move Phase 2 driver to directory Drivers and rename it to AES_Unit_2.h
2022-12-20 Fix Typos in Phase2 drivers
2022-12-21 Fix init of AXI user signals and clean up constraints file
    [AES_Interface_M_v1_0.vhd]
2022-12-29 Change python scripts to easily switch hex output via command line arg
2023-01-02 Fix AES_Unit AXI Parameter init
    [AES_Unit.vhd]
2023-01-02 Revert "Use cascading mem in ControlLogic"
    This reverts commit 5606e9d79d94e9a1bee3c8f6ac29332a61c7624a.
    Done for better structuring the commits.
    [ControlLogic.vhd]
2023-01-02 Reorder the addresses in VHDL to allow smaller memory
    The memory size per channel was lowered to 80 bytes
    Also fixed some bugs regarding the cascaded memory
    [ControlLogic.vhd, common.vhd]
2023-01-02 Finalize cascaded memory changes
    Fix bug in ControlLogic
    Adjust the Register Addresses in the Driver
    [ControlLogic.vhd]
2023-01-02 Adapt driver selftest to new memory and regset structure
2023-01-02 Make some final improvements to aes_test.c
    Add output of aes_test as txt file to repo
    Resolve remaining TODOs
    [aes_test.c]
2023-01-07 Make minor fixes and improvements to test files
    [TestAESCore.vhd, TestAESCoreGCM.vhd, Test_AES_Unit_2.vhd, Test_AES_Unit_Sim_Bd.vhd]
2023-02-19 Delay setting callbacks in Driver GCM function
    Currently, the callbacks in startComputationGCM() were called after
    (and only after) the init phase, which isn't desirable.
    Now, they're called after the last phase (header or payload)
2023-02-26 Rework scheduler process of ControlLogic
    [ControlLogic.vhd]
2023-03-01 Fix small typos in test files
    [TestAESCore.vhd, TestAESCoreGCM.vhd]
2023-03-19 Fix bug in ControlLogic where channel starts one cycle later than necessary
    [ControlLogic.vhd]
2023-07-25 Fix error in Driver selftest, add interruptcallback fun to Driver
2023-07-25 Adapt SR reading and writing in driver to support >8 channels
2023-07-26 Remove avoidChannelIdx from BinarySearch
    [BinarySearch.vhd, ControlLogic.vhd]
2023-07-27 Fix bug in BinarySearch that ignores the last channel when NUM_CHANNELS is odd
    [BinarySearch.vhd, ControlLogic.vhd]
2023-07-28 Fix minor mistakes in Testing files
    [TestControlLogic.vhd, Test_AES_Unit_2_Sim_Bd_Scheduler.vhd]
2023-07-28 Fix bug in driver bit macros, improve test program
    [aes_test.c]
2024-03-27 Improve Driver: Remove Xilinx dependencies
2026-10-23 Drivers: Adapt to support various (constant) key sizes
    Introduced macro AES_KEY_SIZE_BITS to configure key size
    Increased size of key register to 32 byte (moving register positions
    accordingly)
    Renamed macro BLOCK_SIZE to AES_BLOCK_SIZE
    Improved IV setter function for CTR & GCM
    Added separate getters & setters for H registers
2026-10-31 Drivers: Add KEYSIZE_SEL part to CR for configuring key size
